MorrisYLin/ASIC_II_PCB/Lab_1_Morris_Lin_ASIC_II.kicad_pcb

## KiCad design Lab_1_Morris_Lin_ASIC_II.kicad_pcb (2026-10-01)

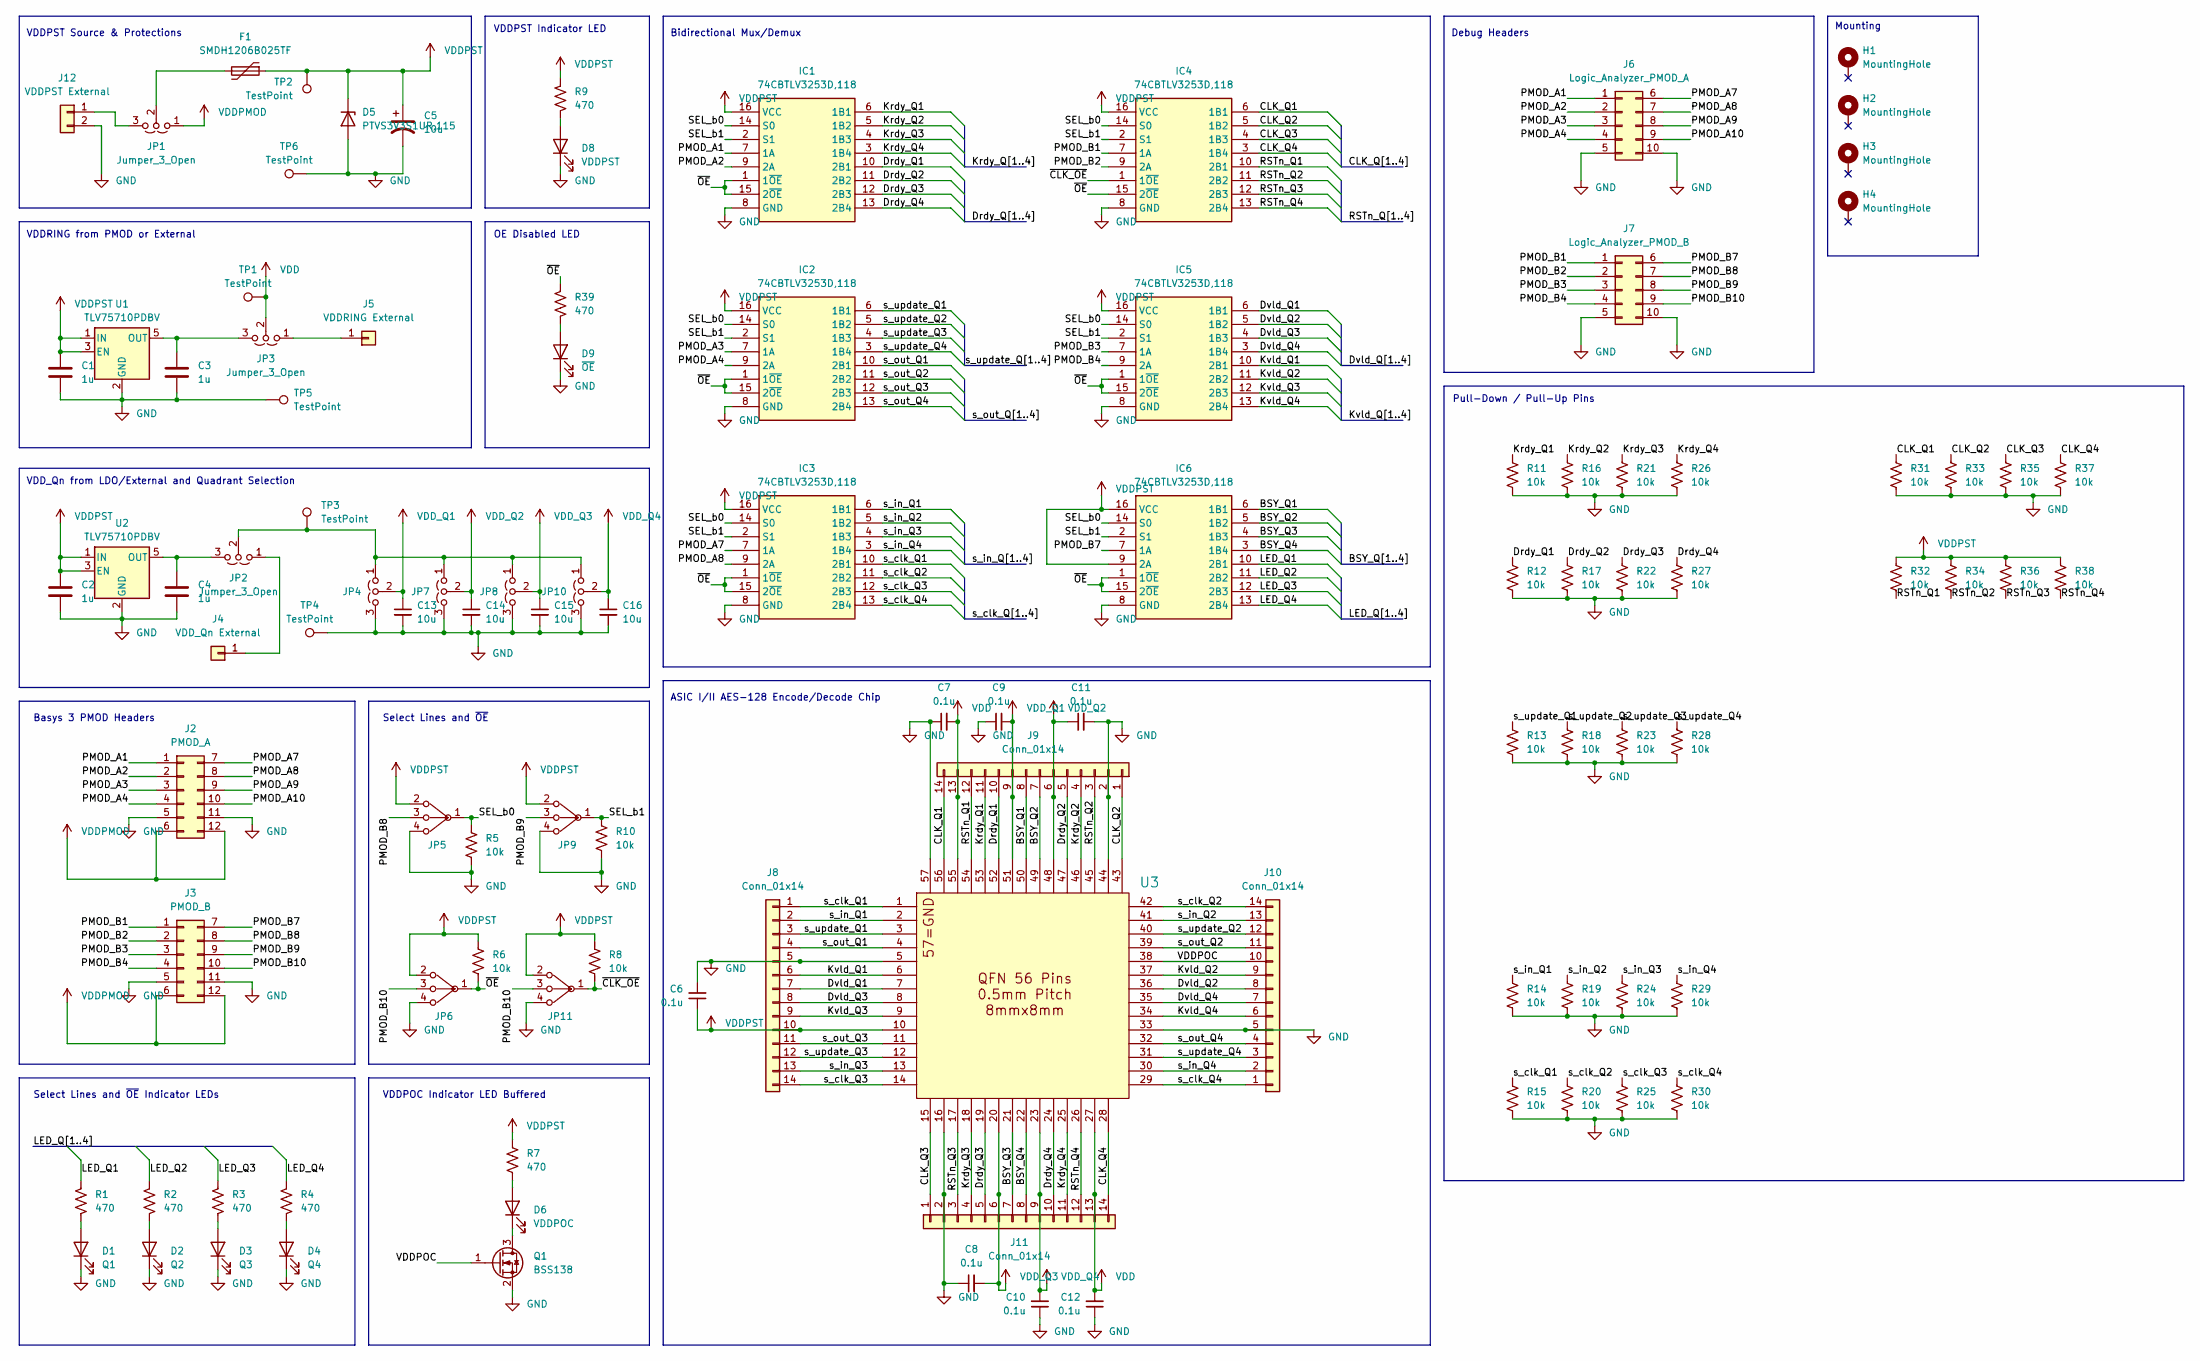
[picture p1: schematic Lab_1_Morris_Lin_ASIC_II.kicad_sch]

Parts:
C1, C2, C3, C4: 1u; C_1206_3216Metric_Pad1.33x1.80mm_HandSolder
C5, C13, C14, C15, C16: 10u; C_1206_3216Metric_Pad1.33x1.80mm_HandSolder
C6, C7, C8, C9, C10, C11, C12: 0.1u; C_1206_3216Metric_Pad1.33x1.80mm_HandSolder
D1: Q1; LED_1206_3216Metric_Pad1.42x1.75mm_HandSolder
D2: Q2; LED_1206_3216Metric_Pad1.42x1.75mm_HandSolder
D3: Q3; LED_1206_3216Metric_Pad1.42x1.75mm_HandSolder
D4: Q4; LED_1206_3216Metric_Pad1.42x1.75mm_HandSolder
D5: PTVS3V3S1UR,115; Nexperia_CFP3_SOD-123W; Mouser Part Number 771-PTVS3V3S1UR115
D6: VDDPOC; LED_1206_3216Metric_Pad1.42x1.75mm_HandSolder
D8: VDDPST; LED_1206_3216Metric_Pad1.42x1.75mm_HandSolder
D9: ~{OE}; LED_1206_3216Metric_Pad1.42x1.75mm_HandSolder
F1: SMDH1206B025TF; Fuse_1206_3216Metric_Pad1.42x1.75mm_HandSolder; Mouser Part Number 603-SMDH1206B025TF
H1, H2, H3, H4: MountingHole; MountingHole_3.2mm_M3_DIN965_Pad_TopBottom
IC1, IC2, IC3, IC4, IC5, IC6: 74CBTLV3253D,118; SOIC127P600X175-16N; Mouser Part Number 771-74CBTLV3253D118
J2: PMOD_A; PinHeader_2x06_P2.54mm_Horizontal
J3: PMOD_B; PinHeader_2x06_P2.54mm_Horizontal
J4: VDD_Qn External; Banana_Jack_1Pin
J5: VDDRING External; Banana_Jack_1Pin
J6: Logic_Analyzer_PMOD_A; PinHeader_VertNum_2x05_P2.54mm_Vertical
J7: Logic_Analyzer_PMOD_B; PinHeader_VertNum_2x05_P2.54mm_Vertical
J8, J9, J10, J11: Conn_01x14; PinHeader_1x14_P2.54mm_Vertical
J12: VDDPST External; Banana_Jack_2Pin
JP1, JP2, JP3, JP4, JP7, JP8, JP10: Jumper_3_Open; PinHeader_1x03_P2.54mm_Vertical
JP5, JP6, JP9, JP11: Jumper_3_Open; PinHeader_SP3T_P2.54mm_Vertical
Q1: BSS138; SOT-23; Mouser Part Number 771-BSS138AK-QR
R1, R2, R3, R4, R7, R9, R39: 470; R_1206_3216Metric_Pad1.30x1.75mm_HandSolder; Mouser Part Number 660-RK73H2BTTD4700F
R5, R6, R8, R10, R11, R12, R13, R14, R15, R16, R17, R18, R19, R20, R21, R22, R23, R24, R25, R26, R27, R28, R29, R30, R31, R32, R33, R34, R35, R36, R37, R38: 10k; R_1206_3216Metric_Pad1.30x1.75mm_HandSolder; Mouser Part Number 71-CRCW1206J-10K-E3
TP1, TP2, TP3, TP4, TP5, TP6: TestPoint; TestPoint_Loop_D2.54mm_Drill1.5mm_Beaded
U1, U2: TLV75710PDBV; SOT-23-5; Mouser Part Number 595-TLV75710PDBVR
U3: QFN56ASIC

Connections:
/BSY_Q1: IC6.6 (1B1), J9.8, U3.50
/BSY_Q2: IC6.5 (1B2), J9.7, U3.49
/BSY_Q3: IC6.4 (1B3), J11.7, U3.21
/BSY_Q4: IC6.3 (1B4), J11.8, U3.22
/CLK_Q1: IC4.6 (1B1), J9.14, R31.1, U3.56
/CLK_Q2: IC4.5 (1B2), J9.1, R33.1, U3.43
/CLK_Q3: IC4.4 (1B3), J11.1, R35.1, U3.15
/CLK_Q4: IC4.3 (1B4), J11.14, R37.1, U3.28
/Drdy_Q1: IC1.10 (2B1), J9.10, R12.1, U3.52
/Drdy_Q2: IC1.11 (2B2), J9.5, R17.1, U3.47
/Drdy_Q3: IC1.12 (2B3), J11.5, R22.1, U3.19
/Drdy_Q4: IC1.13 (2B4), J11.10, R27.1, U3.24
/Dvld_Q1: IC5.6 (1B1), J8.7, U3.7
/Dvld_Q2: IC5.5 (1B2), J10.8, U3.36
/Dvld_Q3: IC5.4 (1B3), J8.8, U3.8
/Dvld_Q4: IC5.3 (1B4), J10.7, U3.35
/Krdy_Q1: IC1.6 (1B1), J9.11, R11.1, U3.53
/Krdy_Q2: IC1.5 (1B2), J9.4, R16.1, U3.46
/Krdy_Q3: IC1.4 (1B3), J11.4, R21.1, U3.18
/Krdy_Q4: IC1.3 (1B4), J11.11, R26.1, U3.25
/Kvld_Q1: IC5.10 (2B1), J8.6, U3.6
/Kvld_Q2: IC5.11 (2B2), J10.9, U3.37
/Kvld_Q3: IC5.12 (2B3), J8.9, U3.9
/Kvld_Q4: IC5.13 (2B4), J10.6, U3.34
/LED_Q1: IC6.10 (2B1), R1.1
/LED_Q2: IC6.11 (2B2), R2.1
/LED_Q3: IC6.12 (2B3), R3.1
/LED_Q4: IC6.13 (2B4), R4.1
/PMOD_A1: IC1.7 (1A), J2.1, J6.1
/PMOD_A2: IC1.9 (2A), J2.2, J6.2
/PMOD_A3: IC2.7 (1A), J2.3, J6.3
/PMOD_A4: IC2.9 (2A), J2.4, J6.4
/PMOD_A7: IC3.7 (1A), J2.7, J6.6
/PMOD_A8: IC3.9 (2A), J2.8, J6.7
/PMOD_A9: J2.9, J6.8
/PMOD_A10: J2.10, J6.9
/PMOD_B1: IC4.7 (1A), J3.1, J7.1
/PMOD_B2: IC4.9 (2A), J3.2, J7.2
/PMOD_B3: IC5.7 (1A), J3.3, J7.3
/PMOD_B4: IC5.9 (2A), J3.4, J7.4
/PMOD_B7: IC6.7 (1A), J3.7, J7.6
/PMOD_B8: J3.8, J7.7, JP5.3 (C)
/PMOD_B9: J3.9, J7.8, JP9.3 (C)
/PMOD_B10: J3.10, J7.9, JP6.3 (C), JP11.3 (C)
/RSTn_Q1: IC4.10 (2B1), J9.12, R32.2, U3.54
/RSTn_Q2: IC4.11 (2B2), J9.3, R34.2, U3.45
/RSTn_Q3: IC4.12 (2B3), J11.3, R36.2, U3.17
/RSTn_Q4: IC4.13 (2B4), J11.12, R38.2, U3.26
/SEL_b0: IC1.14 (S0), IC2.14 (S0), IC3.14 (S0), IC4.14 (S0), IC5.14 (S0), IC6.14 (S0), JP5.1 (A), R5.1
/SEL_b1: IC1.2 (S1), IC2.2 (S1), IC3.2 (S1), IC4.2 (S1), IC5.2 (S1), IC6.2 (S1), JP9.1 (A), R10.1
/VDDPOC: J10.10, Q1.1 (G), U3.38
/s_clk_Q1: IC3.10 (2B1), J8.1, R15.1, U3.1
/s_clk_Q2: IC3.11 (2B2), J10.14, R20.1, U3.42
/s_clk_Q3: IC3.12 (2B3), J8.14, R25.1, U3.14
/s_clk_Q4: IC3.13 (2B4), J10.1, R30.1, U3.29
/s_in_Q1: IC3.6 (1B1), J8.2, R14.1, U3.2
/s_in_Q2: IC3.5 (1B2), J10.13, R19.1, U3.41
/s_in_Q3: IC3.4 (1B3), J8.13, R24.1, U3.13
/s_in_Q4: IC3.3 (1B4), J10.2, R29.1, U3.30
/s_out_Q1: IC2.10 (2B1), J8.4, U3.4
/s_out_Q2: IC2.11 (2B2), J10.11, U3.39
/s_out_Q3: IC2.12 (2B3), J8.11, U3.11
/s_out_Q4: IC2.13 (2B4), J10.4, U3.32
/s_update_Q1: IC2.6 (1B1), J8.3, R13.1, U3.3
/s_update_Q2: IC2.5 (1B2), J10.12, R18.1, U3.40
/s_update_Q3: IC2.4 (1B3), J8.12, R23.1, U3.12
/s_update_Q4: IC2.3 (1B4), J10.3, R28.1, U3.31
/~CLK_OE: IC4.1 (1~OE), JP11.1 (A), R8.2
/~OE: IC1.1 (1~OE), IC1.15 (2~OE), IC2.1 (1~OE), IC2.15 (2~OE), IC3.1 (1~OE), IC3.15 (2~OE), IC4.15 (2~OE), IC5.1 (1~OE), IC5.15 (2~OE), IC6.1 (1~OE), IC6.15 (2~OE), JP6.1 (A), R6.2, R39.1
GND: C1.2, C2.2, C3.2, C4.2, C5.2, C6.2, C7.1, C8.1, C9.1, C10.1, C11.2, C12.1, C13.2, C14.2, C15.2, C16.2, D1.1 (K), D2.1 (K), D3.1 (K), D4.1 (K), D5.2 (A), D8.1 (K), D9.1 (K), IC1.8 (GND), IC2.8 (GND), IC3.8 (GND), IC4.8 (GND), IC5.8 (GND), IC6.8 (GND), J2.5, J2.11, J3.5, J3.11, J6.5, J6.10, J7.5, J7.10, J8.5, J9.2, J10.5, J11.2, J12.2, JP4.3 (B), JP5.4 (D), JP6.4 (D), JP7.3 (B), JP8.3 (B), JP9.4 (D), JP10.3 (B), JP11.4 (D), Q1.2 (S), R5.2, R10.2, R11.2, R12.2, R13.2, R14.2, R15.2, R16.2, R17.2, R18.2, R19.2, R20.2, R21.2, R22.2, R23.2, R24.2, R25.2, R26.2, R27.2, R28.2, R29.2, R30.2, R31.2, R33.2, R35.2, R37.2, TP4.1 (1_1), TP5.1 (1_1), TP6.1 (1_1), U1.2 (GND), U2.2 (GND), U3.5, U3.16, U3.33, U3.44, U3.57
unnamed: D1.2 (A), R1.2
unnamed: D2.2 (A), R2.2
unnamed: D3.2 (A), R3.2
unnamed: D4.2 (A), R4.2
unnamed: D6.2 (A), R7.2
unnamed: D6.1 (K), Q1.3 (D)
unnamed: D8.2 (A), R9.2
unnamed: D9.2 (A), R39.2
unnamed: J4.1 (Pin_1_1), JP2.1 (A)
unnamed: J5.1 (Pin_1_1), JP3.1 (A)
unnamed: J12.1, JP1.3 (B)
unnamed: F1.2, JP1.2 (C)
unnamed: C4.1, JP2.3 (B), U2.5 (OUT)
unnamed: C3.1, JP3.3 (B), U1.5 (OUT)
unnamed: JP2.2 (C), JP4.1 (A), JP7.1 (A), JP8.1 (A), JP10.1 (A), TP3.1 (1_1)
VDD: C7.2, C12.2, J9.13, J11.13, JP3.2 (C), TP1.1 (1_1), U3.27, U3.55
VDDPMOD: J2.6, J2.12, J3.6, J3.12, JP1.1 (A)
VDDPST: C1.1, C2.1, C5.1, C6.1, D5.1 (K), F1.1, IC1.16 (VCC), IC2.16 (VCC), IC3.16 (VCC), IC4.16 (VCC), IC5.16 (VCC), IC6.9 (2A), IC6.16 (VCC), J8.10, JP5.2 (B), JP6.2 (B), JP9.2 (B), JP11.2 (B), R6.1, R7.1, R8.1, R9.1, R32.1, R34.1, R36.1, R38.1, TP2.1 (1_1), U1.1 (IN), U1.3 (EN), U2.1 (IN), U2.3 (EN), U3.10
VDD_Q1: C9.2, C13.1, J9.9, JP4.2 (C), U3.51
VDD_Q2: C11.1, C14.1, J9.6, JP7.2 (C), U3.48
VDD_Q3: C8.2, C15.1, J11.6, JP8.2 (C), U3.20
VDD_Q4: C10.2, C16.1, J11.9, JP10.2 (C), U3.23

Notes on the sheet:
Select Lines and ~{OE}
VDDRING from PMOD or External
VDDPOC Indicator LED Buffered
VDDPST Indicator LED
Mounting
Select Lines and ~{OE} Indicator LEDs
ASIC I/II AES-128 Encode/Decode Chip
VDD_Qn from LDO/External and Quadrant Selection
OE Disabled LED
Bidirectional Mux/Demux
Basys 3 PMOD Headers
VDDPST Source & Protections
Pull-Down / Pull-Up Pins
Debug Headers

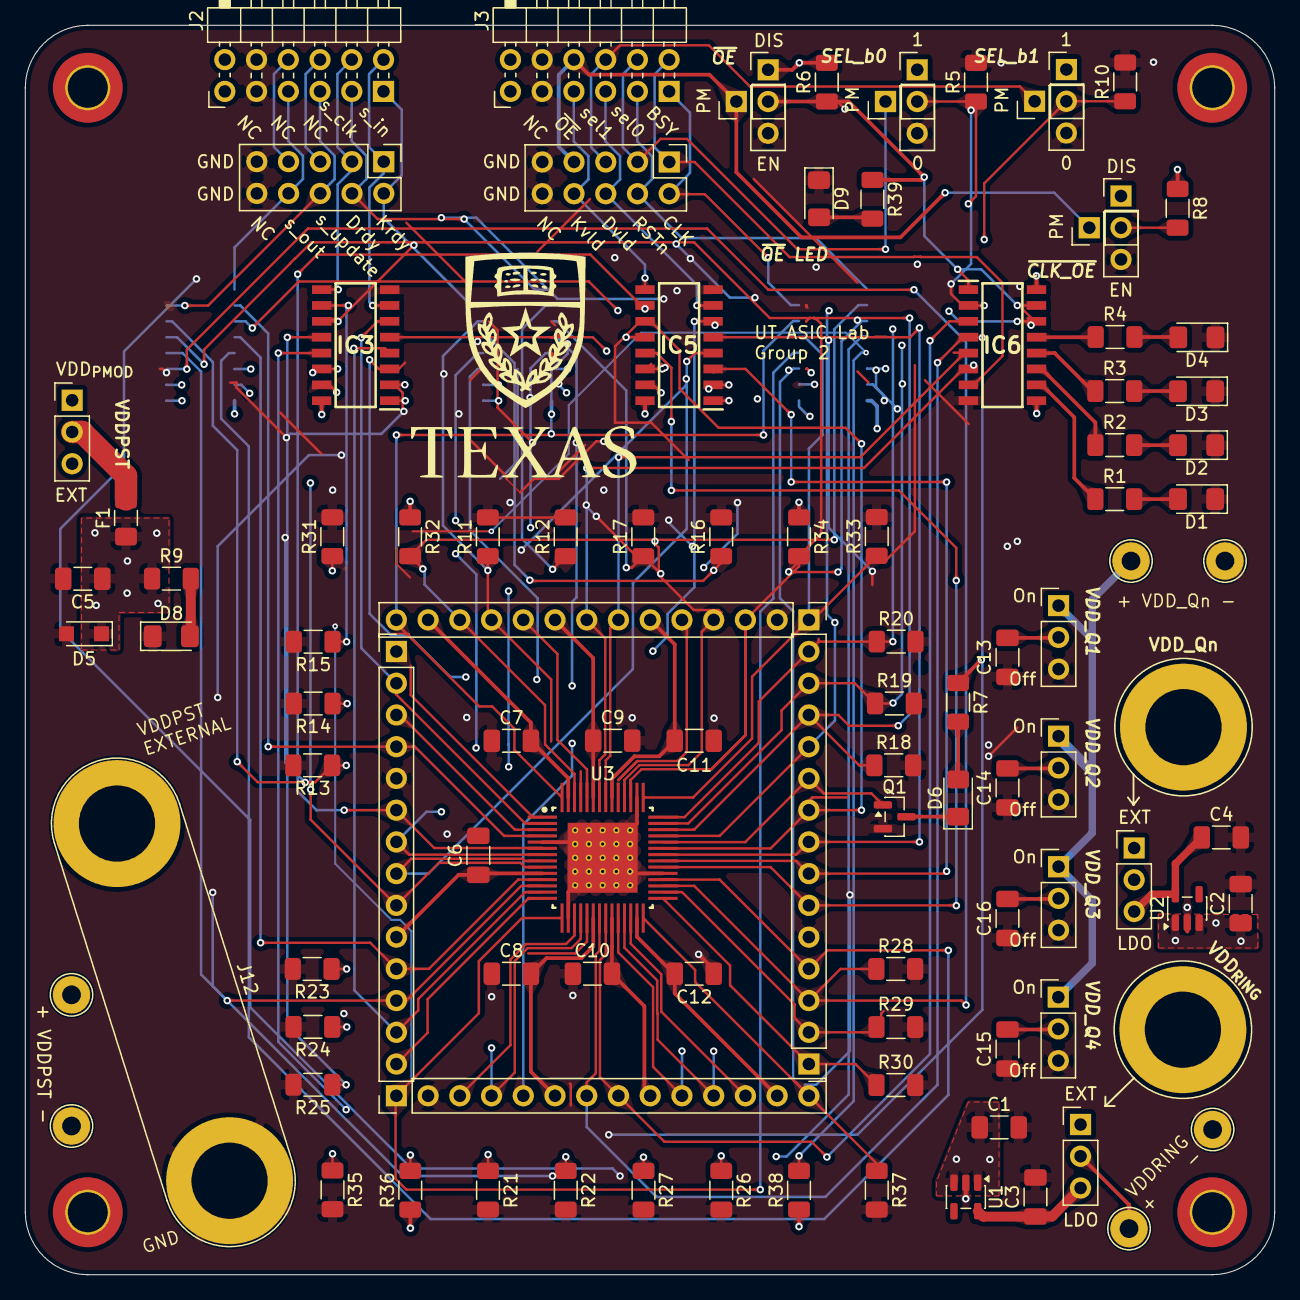
[picture p2: board Lab_1_Morris_Lin_ASIC_II.kicad_pcb from above]

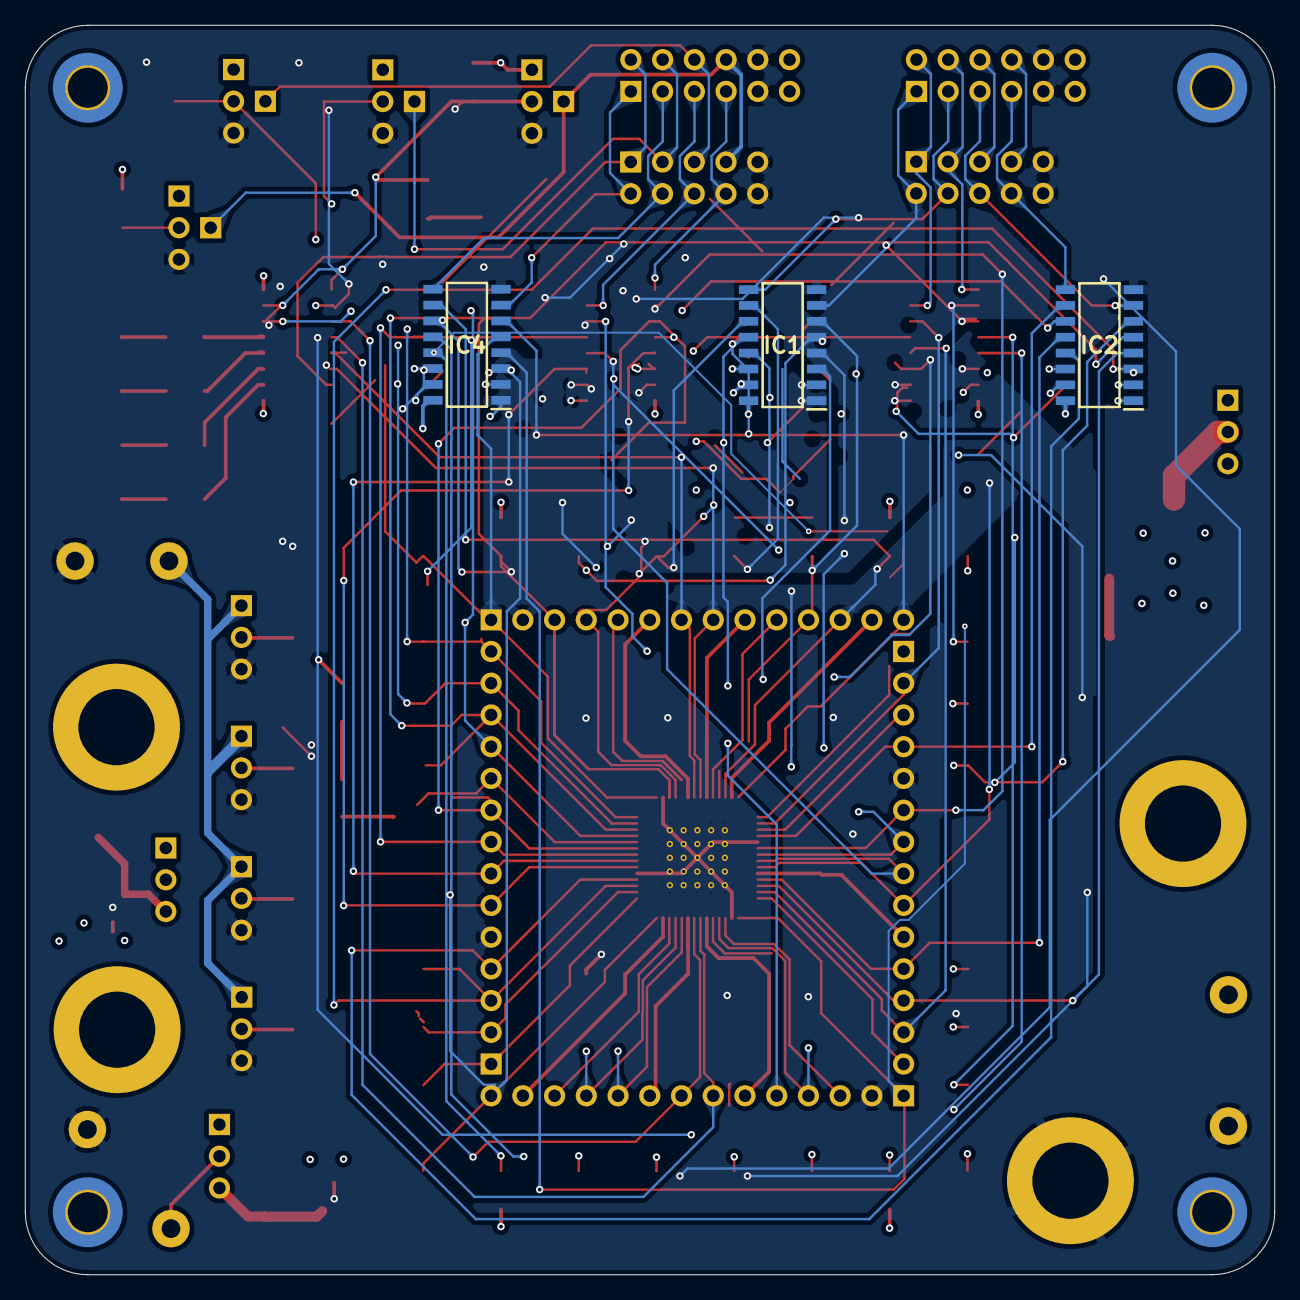
[picture p3: board Lab_1_Morris_Lin_ASIC_II.kicad_pcb from below]

Board: 4 copper layers, 100.0 x 100.0 mm, 106 parts (4 on the bottom side), 92 nets.
