MorrisYLin/ASIC_II_PCB/(commit log)

2026-09-27 Bussed ASIC pins, jumper implementation
    [Lab_1_Morris_Lin_ASIC_II.kicad_pcb, Lab_1_Morris_Lin_ASIC_II.kicad_sch]
2026-09-27 Swapped to 1-of-4 Demux IC setup
    [Lab_1_Morris_Lin_ASIC_II.kicad_pcb, Lab_1_Morris_Lin_ASIC_II.kicad_sch]
2026-09-27 Started adding LDOs
    [Lab_1_Morris_Lin_ASIC_II.kicad_sch]
2026-09-28 Starting routing
    [Lab_1_Morris_Lin_ASIC_II.kicad_pcb, Lab_1_Morris_Lin_ASIC_II.kicad_sch]
2026-09-28 Fanned out ASIC pins
    [Lab_1_Morris_Lin_ASIC_II.kicad_pcb, Lab_1_Morris_Lin_ASIC_II.kicad_sch]
2026-09-28 Added keepout and mux side swapping
    [Lab_1_Morris_Lin_ASIC_II.kicad_pcb]
2026-09-28 blank for run
    [Lab_1_Morris_Lin_ASIC_II.kicad_pcb]
2026-09-28 Routing done, pesky GND zone error remains
    [Lab_1_Morris_Lin_ASIC_II.kicad_pcb]
2026-09-28 Update bom
    [Lab_1_Morris_Lin_ASIC_II.kicad_sch]
2026-09-29 Routing Attempt 2 initial
    [Lab_1_Morris_Lin_ASIC_II.kicad_pcb, Lab_1_Morris_Lin_ASIC_II.kicad_sch]
2026-09-30 Preroute again
    [Lab_1_Morris_Lin_ASIC_II.kicad_pcb]
2026-09-30 Preroute self planned
    [Lab_1_Morris_Lin_ASIC_II.kicad_pcb, Lab_1_Morris_Lin_ASIC_II.kicad_sch]
2026-09-30 Unfinished routing
    [Lab_1_Morris_Lin_ASIC_II.kicad_pcb]
2026-09-30 Routed OE and quadrant select lines
    [Lab_1_Morris_Lin_ASIC_II.kicad_pcb]
2026-10-01 Last 3 nets to go
    [Lab_1_Morris_Lin_ASIC_II.kicad_pcb]
2026-10-01 Finalized Board for Milestone 2
    [Lab_1_Morris_Lin_ASIC_II.kicad_pcb, Lab_1_Morris_Lin_ASIC_II.kicad_sch]
